ElectronDon66/Analog-Arduino-Barometer-/meter7.pdf

29.5

30

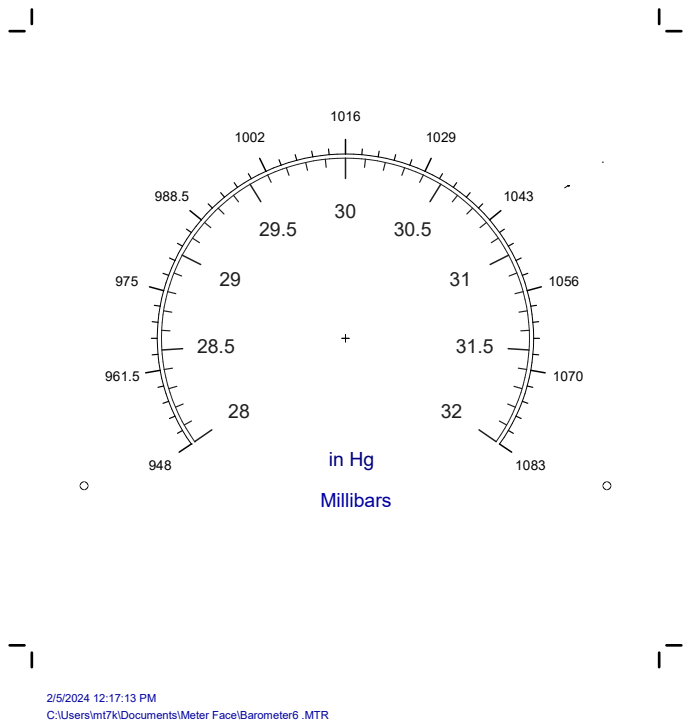
[picture p1: page 1]
Millibars

C:\Users\mt7k\Documents\Meter Face\Barometer6 .MTR
