ElectronDon66/Analog-Arduino-Barometer-/Barometer_Mechanical V4_schem.pdf

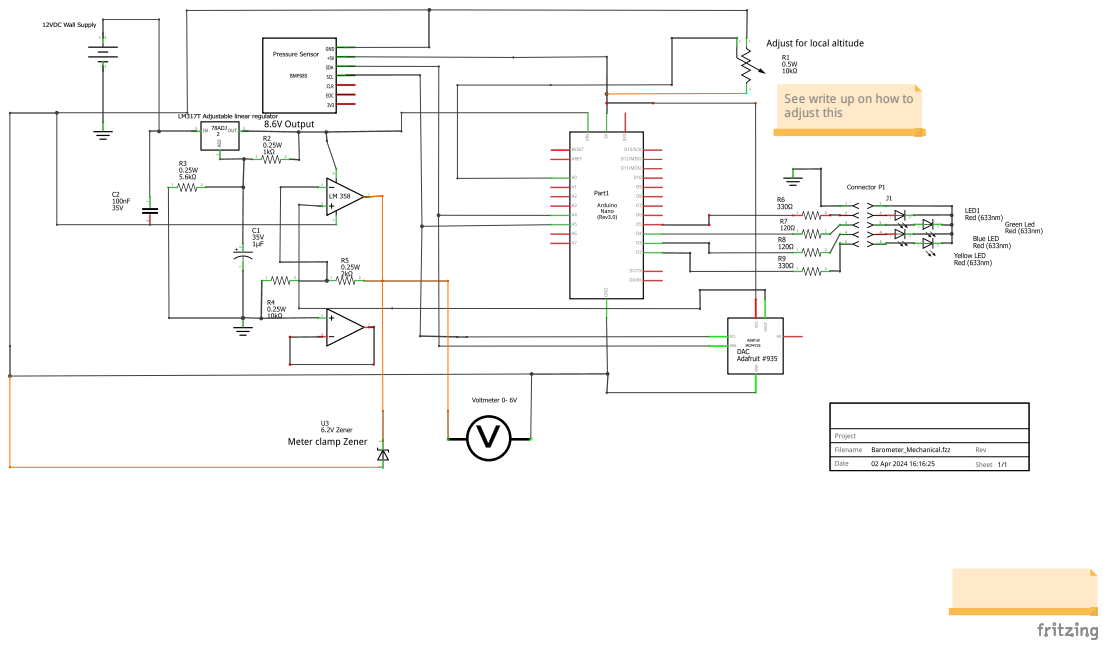
[picture p2: page 1]

See write up on how to
adjust this
