ElectronDon66/Analog-Arduino-Barometer-/Barometer_Mechanical_schem.pdf

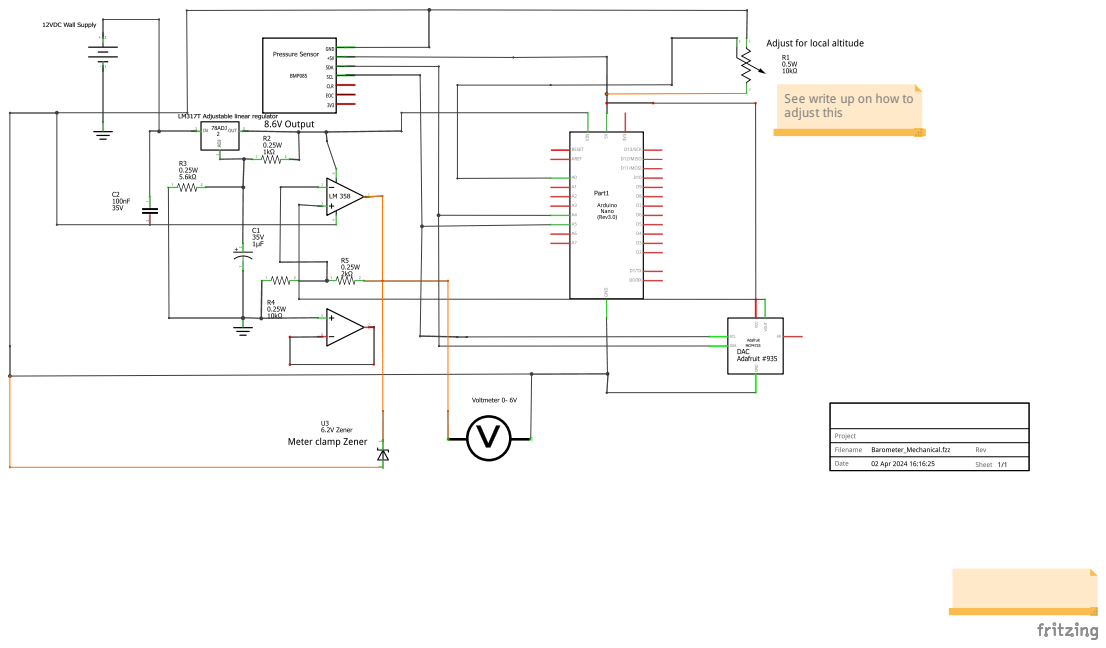
[picture p3: page 1]

See write up on how to
adjust this
